phorton1/Arduino-SeaTalk/docs/images/E80.jpg

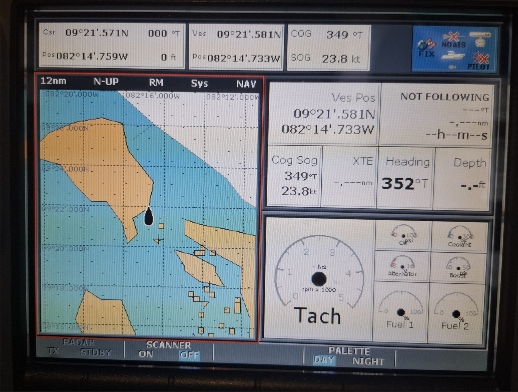
docs/images/E80.jpg
