phorton1/Arduino-SeaTalk/docs/images/power_supply.jpg

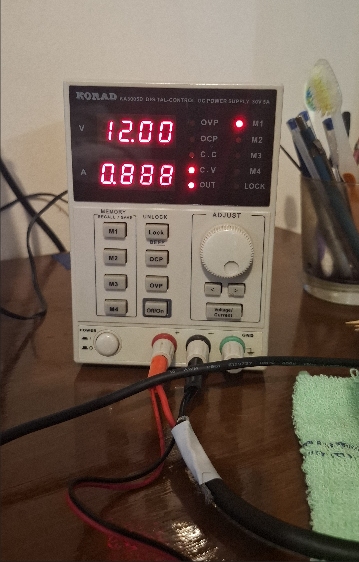
docs/images/power_supply.jpg
