phorton1/Arduino-SeaTalk/docs/kicad/breadboard/breadboard.kicad_pcb

## KiCad design output.sch


Parts:
C4: 100u
M1: Motor_DC
MotorLED1: LED

Connections:
0: C4.2, M1.2 (-), MotorLED1.1 (K)
Resultin: C4.1, M1.1 (+), MotorLED1.2 (A)
