phorton1/Arduino-SeaTalk/ui.h

//---------------------------------------------
// ui.h
//---------------------------------------------
// Serial command processor
//
// Single Character commands
//
// 		x = start/stop simulator
// 		i = reset simulator to initial condition
//
// <cr> delimited commands:
//
//		h = heading and cog
//
//			hN		set heading/cog to N degrees
//			h+N		increase heading/cog by N degrees
//			h-N		decrease heading/cog by N degrees
//
//		s = sog and speed thru water
//
//			sN		set cog/stw to N knots
//			s+N		increase cog/stw by N knots
//			s-N		decrease cog/stw by N knots

	const uint16_t recorded_datagrams[][10] =
		// A series of datagrams recorded from
		// the E80 in Simulation mode.  They were then
		// sent back to the E80 as proof of concept.
	{
		{0x126, 0x04, 0xc2, 0x09, 0x00, 0x00, 0x10},
		{0x127, 0x01, 0x2c, 0x01},
		{0x152, 0x01, 0xee, 0x00},
		{0x153, 0x30, 0x2b},
		{0x157, 0x00, 0x14},
		{0x123, 0x01, 0x13, 0x43},
		{0x150, 0x02, 0x09, 0x6e, 0x08},
		{0x151, 0x02, 0x52, 0xc1, 0x05},
		{0x158, 0x05, 0x09, 0x54, 0x4d,	0x52, 0x39, 0x8d},
		{0x189, 0xb2, 0x2b, 0x00, 0x20},
		{0x189, 0x72, 0x2c, 0x00, 0x20},
		{0x110, 0x01, 0x01, 0x37},
		{0x111, 0x01, 0x14, 0x02},
		{0x120, 0x01, 0xfc, 0x00},
		{0x126, 0x04, 0xd5, 0x09, 0x00, 0x00,0x10},
		{0x127, 0x01, 0x2c},
		{0x152, 0x01, 0xf0, 0x00},
		{0x153, 0xf0, 0x2b},
		{0x157, 0x00, 0x14},
		{0x123, 0x01, 0x14, 0x44},
		{0x189, 0x72, 0x2c, 0x00, 0x20},
		{0x189, 0x42, 0x00, 0x00, 0x20},
		{0x110, 0x01, 0x01, 0x3b},
		{0x111, 0x01, 0x13, 0x08},
		{0x120, 0x01, 0xff, 0x00},
		{0}
	};
