phorton1/Arduino-SeaTalk/(commit log)

2025-05-23 initial commit new repo
    [breadboard.kicad_pcb, breadboard.sch]
2025-05-23 added ALIVE_LEDs to all E80 related programs and fixed preferences.txt as needed
    [SeaTalk.ino]
2025-07-29 added BC547 pulse for ST50 Log meter testing which worked
    [breadboard.sch]
2025-08-07 added basic Wind Instrument test
    [breadboard.sch]
2025-08-26 Desktop Integration testing of E80 and GX2410GPS VHF Radio (AIS) - started actual readmes with photos - added NMEA0183 decode_ais.cpp (after much hassle with copilot AI) - added NMEA0183 #ifdef WITH_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
    [process.cpp, ui.h]
2025-09-11 moved to Arduino-libraries-Boat
